dhansel/PaperTapeReader/schematics/mainboard-pcb.pdf

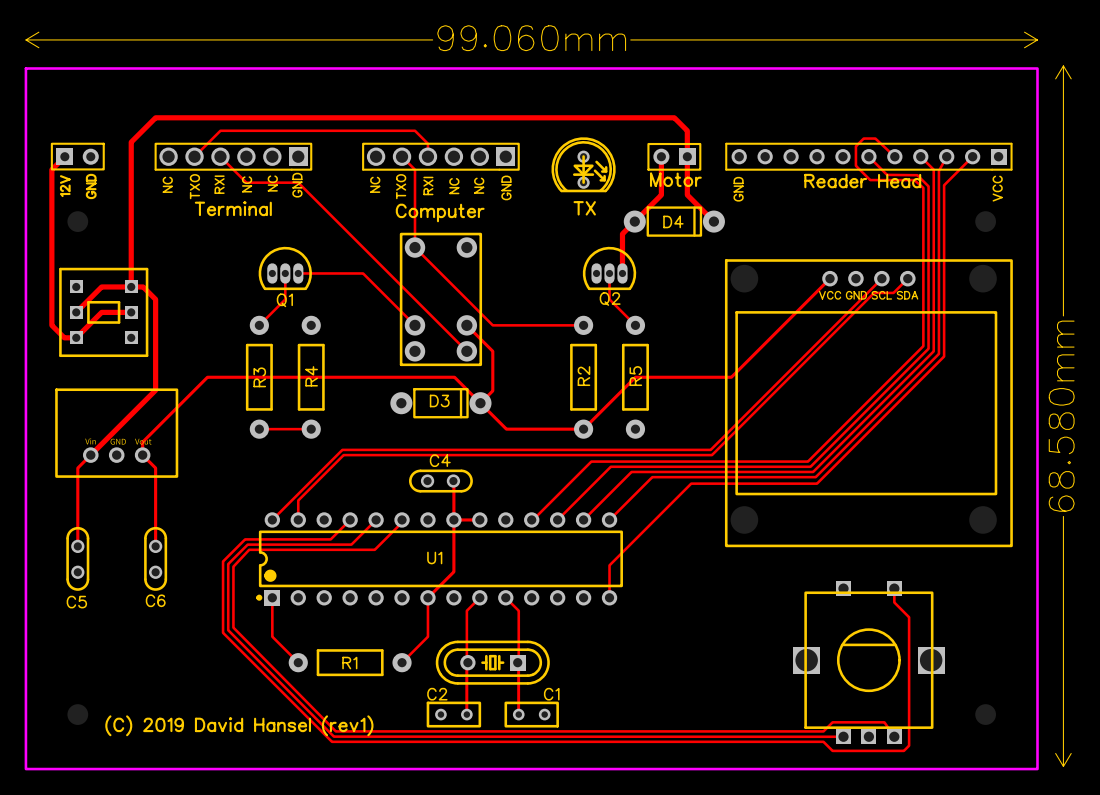
[picture p13: page 1]
