dhansel/PaperTapeReader/schematics/mainboard-schematic.pdf

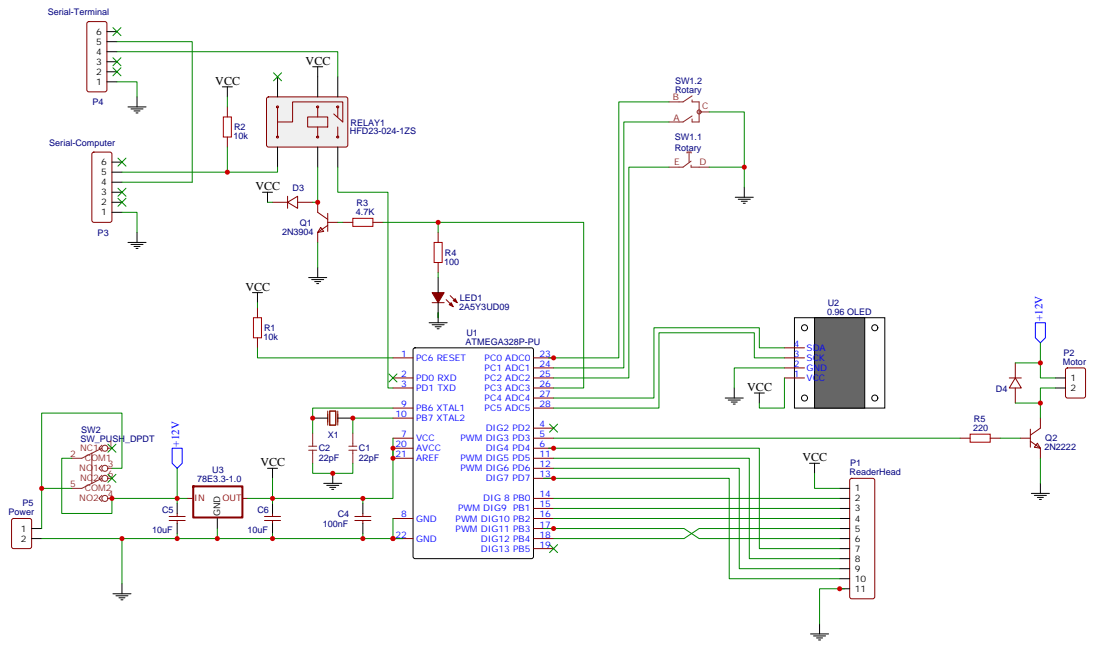
[picture p14: page 1]
