dhansel/PaperTapeReader/schematics/readerhead-emitter-pcb.pdf

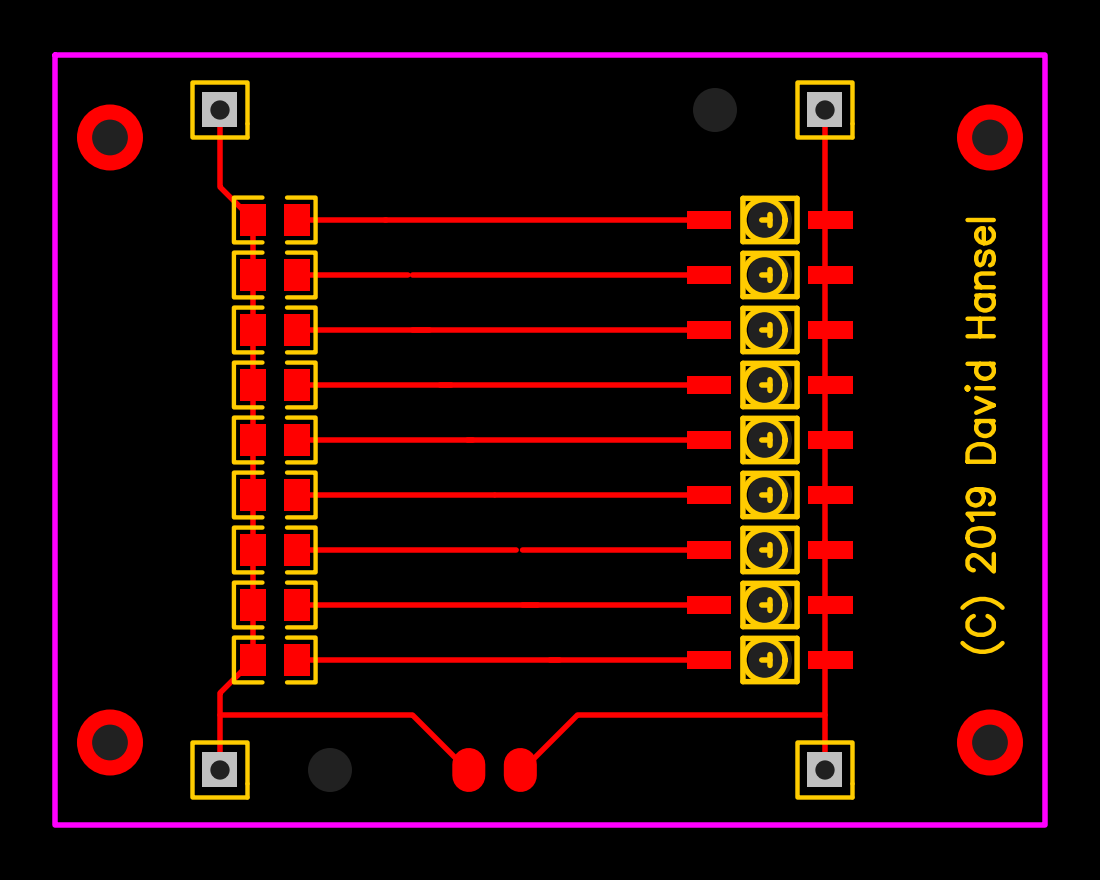
[picture p15: page 1]
