dhansel/PaperTapeReader/schematics/readerhead-sensor-pcb.pdf

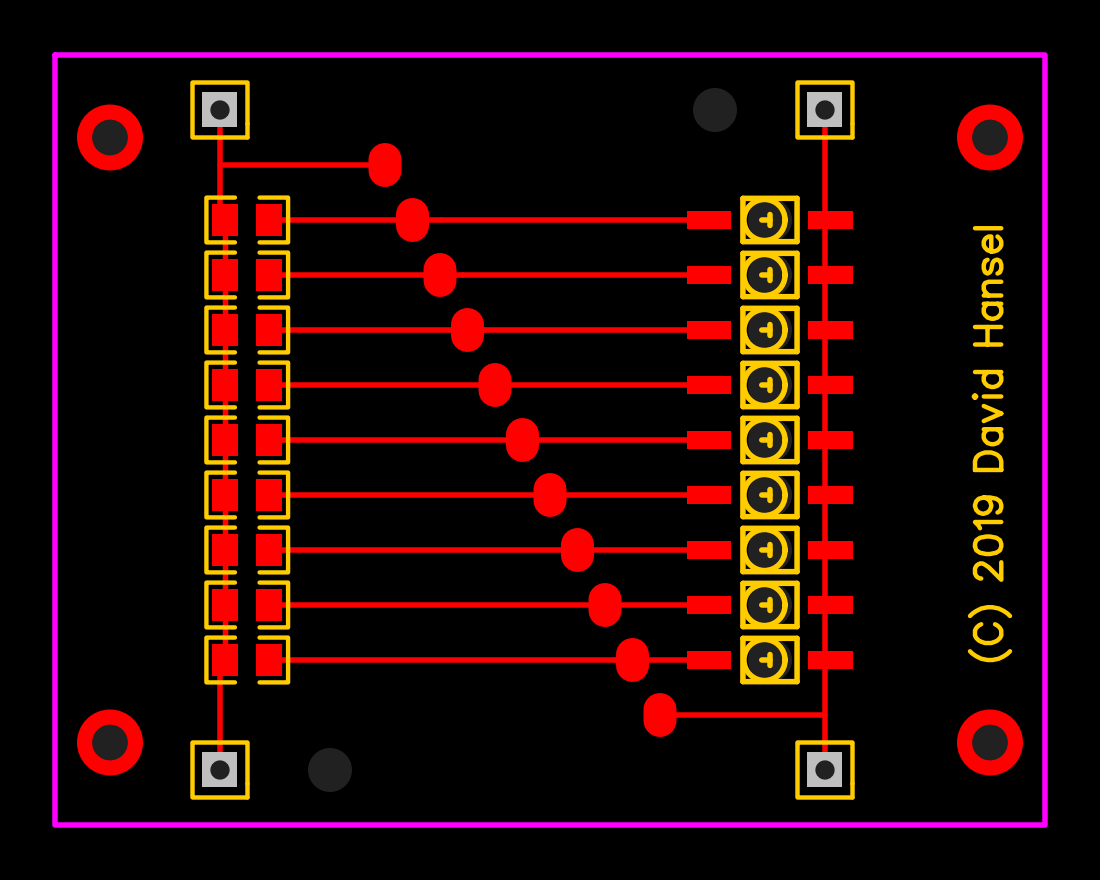
[picture p16: page 1]
