dhansel/PaperTapeReader/(list of files, drawings)

Other design files:
schematics/mainboard-easyeda-pcb.json
schematics/mainboard-easyeda-schematic.json
schematics/readerhead-emitter-easyeda-pcb.json
schematics/readerhead-sensor-easyeda-pcb.json
