dhansel/PaperTapeReader/firmware/PaperTapeReader/basic.h

const byte basic[] PROGMEM = {
  0xae, // leader
  0xc9, 0x7a, 0x47, 0x80, 0x57, 0x01, 0xdb, 0x0f, 0xa0, 0xc2, 0x01, 0xe6, 0x00, 0xdb, 0xc9, 0x67,
  0x0f, 0xa0, 0xcd, 0x6f, 0x0f, 0xa0, 0xcd, 0x0f, 0x8e, 0xc3, 0x13, 0xd3, 0x11, 0xd3, 0x01, 0xd3,
  0x4f, 0x3e, 0x01, 0x4d, 0x3e, 0x01, 0x43, 0x3e, 0x0f, 0x47, 0xca, 0xb9, 0x0f, 0xa0, 0xcd, 0x48,
  0x0f, 0x61, 0xc2, 0x0d, 0x23, 0x0f, 0x89, 0xc2, 0xbe, 0x77, 0xe1, 0x0f, 0x8c, 0xd2, 0x19, 0xff,
  0x4e, 0x11, 0x0f, 0x73, 0xd2, 0x19, 0xf1, 0x00, 0x11, 0xe5, 0x0f, 0xa0, 0xcd, 0x0f, 0x97, 0xcd,
  0x00, 0x06, 0x4f, 0x0f, 0xa0, 0xcd, 0xe9, 0x0f, 0x97, 0xcd, 0x0f, 0x47, 0xc2, 0x78, 0xfe, 0x0f,
  0x58, 0xca, 0x3c, 0xfe, 0x0f, 0xa0, 0xcd, 0x0f, 0xa8, 0x32, 0x3c, 0x0f, 0xa1, 0x32, 0x0f, 0xa3,
  0x22, 0x78, 0x12, 0xd3, 0x04, 0x3e, 0x13, 0xd3, 0x2f, 0x12, 0xd3, 0xaf, 0x40, 0x2e, 0x0f, 0x3c,
  0xc3, 0xc2, 0x01, 0x21, 0x06, 0x06, 0xda, 0x00, 0x06, 0x0f, 0x3c, 0xda, 0x2d, 0x17, 0x0f, 0x30,
  0xda, 0x17, 0x10, 0x06, 0x0f, 0x3c, 0xda, 0x02, 0x2e, 0x17, 0x0f, 0x3c, 0xda, 0x20, 0x2e, 0x17,
  0x0f, 0x28, 0xda, 0x17, 0x00, 0x06, 0xca, 0x26, 0xff, 0xdb, 0x0f, 0xb2, 0x31, 0xf3, 0x00, 0x00,
  0x3c, 0xff, 0xff, 0x00, 0xc7, 0x4f, 0xc4, 0x46, 0xc3, 0x4f, 0xd6, 0x4f, 0xcd, 0x55, 0xd3, 0x42,
  0xd3, 0x44, 0xc4, 0x2f, 0xb0, 0x49, 0xc4, 0x2c, 0x00, 0x00, 0x00, 0x00, 0x00, 0x00, 0x00, 0x00,
  0x00, 0x00, 0x00, 0x00, 0x00, 0x00, 0x00, 0x00, 0x00, 0x00, 0x00, 0x00, 0x00, 0x00, 0x00, 0x00,
  0x00, 0x00, 0x00, 0x00, 0x00, 0x00, 0x00, 0x00, 0x00, 0x00, 0x00, 0x00, 0x00, 0x00, 0x00, 0x00,
  0x00, 0x00, 0x00, 0x00, 0x00, 0x00, 0x00, 0x00, 0x00, 0x00, 0x00, 0x00, 0x00, 0x00, 0x00, 0x00,
  0x00, 0x00, 0x00, 0x00, 0x00, 0x00, 0x00, 0x00, 0x00, 0x00, 0x00, 0x00, 0x00, 0x00, 0x00, 0x00,
  0x00, 0x00, 0x00, 0x00, 0x00, 0x00, 0x00, 0x00, 0x1a, 0x0f, 0x00, 0x00, 0x00, 0x00, 0x00, 0x00,
  0x00, 0x00, 0x00, 0x00, 0x00, 0x00, 0x00, 0x00, 0x00, 0x00, 0x00, 0x00, 0x00, 0x00, 0x00, 0x00,
  0x00, 0x00, 0x00, 0x00, 0x00, 0x00, 0x20, 0x45, 0x52, 0x52, 0x4f, 0xd2, 0x00, 0x20, 0x49, 0x4e,
  0xa0, 0x00, 0x0d, 0x4f, 0xcb, 0x0d, 0x00, 0x21, 0x04, 0x00, 0x39, 0x7e, 0x23, 0xfe, 0x81, 0xc0,
  0xf7, 0xe3, 0xe7, 0x01, 0x0d, 0x00, 0xe1, 0xc8, 0x09, 0xc3, 0x96, 0x01, 0xcd, 0xc3, 0x01, 0xc5,
  0xe3, 0xc1, 0xe7, 0x7e, 0x02, 0xc8, 0x0b, 0x2b, 0xc3, 0xad, 0x01, 0xe5, 0x2a, 0x6b, 0x01, 0x06,
  0x00, 0x09, 0x09, 0xcd, 0xc3, 0x01, 0xe1, 0xc9, 0xd5, 0xeb, 0x21, 0xde, 0xff, 0x39, 0xe7, 0xeb,
  0xd1, 0xd0, 0x1e, 0x0c, 0x01, 0x1e, 0x02, 0x01, 0x1e, 0x14, 0xcd, 0xb5, 0x02, 0xcd, 0x8a, 0x05,
  0x21, 0xfa, 0x00, 0x57, 0x3e, 0x3f, 0xdf, 0x19, 0x7e, 0xdf, 0xd7, 0xdf, 0x21, 0x81, 0x01, 0xcd,
  0xa3, 0x05, 0x2a, 0x61, 0x01, 0x7c, 0xa5, 0x3c, 0xc4, 0x2f, 0x0b, 0x01, 0xc0, 0xc1, 0x21, 0x8d,
  0x01, 0xcd, 0x21, 0xf5, 0x3c, 0xff, 0xfe, 0x01, 0x0d, 0x21, 0xff, 0xff, 0x22, 0x61, 0x01, 0xcd,
  0x3c, 0x03, 0xd7, 0x3c, 0x3d, 0xca, 0xff, 0x01, 0xf5, 0xcd, 0x9d, 0x04, 0xd5, 0xcd, 0xcc, 0x02,
  0x47, 0xd1, 0xf1, 0xd2, 0x3e, 0x04, 0xd5, 0xc5, 0xd7, 0xb7, 0xf5, 0xcd, 0x7d, 0x02, 0xc5, 0xd2,
  0x39, 0x02, 0xeb, 0x2a, 0x67, 0x01, 0x1a, 0x02, 0x03, 0x13, 0xe7, 0xc2, 0x2c, 0x02, 0x60, 0x69,
  0x22, 0x67, 0x01, 0xd1, 0xf1, 0xca, 0x60, 0x02, 0x2a, 0x67, 0x01, 0xe3, 0xc1, 0x09, 0xe5, 0xcd,
  0xa7, 0x01, 0xe1, 0x22, 0x67, 0x01, 0xeb, 0x74, 0x23, 0x23, 0xd1, 0x73, 0x23, 0x72, 0x23, 0x11,
  0x13, 0x01, 0x1a, 0x77, 0x23, 0x13, 0xb7, 0xc2, 0x58, 0x02, 0xcd, 0xa2, 0x02, 0x23, 0xeb, 0x62,
  0x6b, 0x7e, 0x23, 0xb6, 0xca, 0xff, 0x01, 0x23, 0x23, 0x23, 0xaf, 0xbe, 0x23, 0xc2, 0x71, 0x02,
  0xeb, 0x73, 0x23, 0x72, 0xc3, 0x65, 0x02, 0x2a, 0x65, 0x01, 0x44, 0x4d, 0x7e, 0x23, 0xb6, 0x2b,
  0xc8, 0xc5, 0xf7, 0xf7, 0xe1, 0xe7, 0xe1, 0xc1, 0x3f, 0xc8, 0x3f, 0xd0, 0xc3, 0x80, 0x02, 0xc0,
  0x2a, 0x65, 0x01, 0xaf, 0x77, 0x23, 0x77, 0x23, 0x22, 0x67, 0x01, 0xc0, 0x2a, 0x65, 0x01, 0x2b,
  0x22, 0x5d, 0x01, 0xcd, 0x69, 0x04, 0x2a, 0x67, 0x01, 0x22, 0x69, 0x01, 0x22, 0x6b, 0x01, 0xc1,
  0x2a, 0x63, 0x01, 0xf9, 0xaf, 0x6f, 0xe5, 0xc5, 0x2a, 0x5d, 0x01, 0xc9, 0x3e, 0x3f, 0xdf, 0x3e,
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
