dhansel/PaperTapeReader/firmware/PaperTapeReader/lunar.h

const byte lunar[] PROGMEM = { 
   0x00, // leader
   0x31, 0x30, 0x30, 0x20, 0x52, 0x45, 0x4d, 0x2d, 0x2d, 0x2d, 0x2d, 0x2d, 0x2d, 0x2d, 0x2d, 0x2d,
   0x2d, 0x2d, 0x2d, 0x2d, 0x2d, 0x2d, 0x2d, 0x2d, 0x2d, 0x2d, 0x2d, 0x2d, 0x2d, 0x2d, 0x2d, 0x2d,
   0x2d, 0x2d, 0x2d, 0x2d, 0x2d, 0x2d, 0x2d, 0x2d, 0x2d, 0x2d, 0x2d, 0x2d, 0x2d, 0x2d, 0x2d, 0x2d,
   0x2d, 0x2d, 0x2d, 0x2d, 0x2d, 0x2d, 0x2d, 0x2d, 0x2d, 0x2d, 0x2d, 0x0d, 0x0a, 0x31, 0x30, 0x31,
   0x20, 0x52, 0x45, 0x4d, 0x20, 0x20, 0x20, 0x20, 0x20, 0x20, 0x20, 0x4c, 0x20, 0x20, 0x41, 0x20,
   0x20, 0x4e, 0x20, 0x20, 0x44, 0x20, 0x20, 0x45, 0x20, 0x20, 0x52, 0x0d, 0x0a, 0x31, 0x30, 0x32,
   0x20, 0x52, 0x45, 0x4d, 0x2d, 0x2d, 0x2d, 0x2d, 0x2d, 0x2d, 0x2d, 0x2d, 0x2d, 0x2d, 0x2d, 0x2d,
   0x2d, 0x2d, 0x2d, 0x2d, 0x2d, 0x2d, 0x2d, 0x2d, 0x2d, 0x2d, 0x2d, 0x2d, 0x2d, 0x2d, 0x2d, 0x2d,
   0x2d, 0x2d, 0x2d, 0x2d, 0x2d, 0x2d, 0x2d, 0x2d, 0x2d, 0x2d, 0x2d, 0x2d, 0x2d, 0x2d, 0x2d, 0x2d,
   0x2d, 0x2d, 0x2d, 0x2d, 0x2d, 0x2d, 0x2d, 0x2d, 0x0d, 0x0a, 0x31, 0x30, 0x33, 0x20, 0x52, 0x45,
   0x4d, 0x20, 0x20, 0x20, 0x20, 0x20, 0x20, 0x20, 0x20, 0x4a, 0x55, 0x4e, 0x45, 0x20, 0x31, 0x36,
   0x2c, 0x20, 0x31, 0x39, 0x37, 0x37, 0x0d, 0x0a, 0x31, 0x30, 0x34, 0x20, 0x52, 0x45, 0x4d, 0x20,
   0x54, 0x48, 0x49, 0x53, 0x20, 0x56, 0x45, 0x52, 0x53, 0x49, 0x4f, 0x4e, 0x20, 0x4f, 0x46, 0x20,
   0x4c, 0x55, 0x4e, 0x41, 0x52, 0x20, 0x4c, 0x41, 0x4e, 0x44, 0x45, 0x52, 0x20, 0x49, 0x53, 0x20,
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
   0x54, 0x41, 0x4b, 0x45, 0x4e, 0x22, 0x0d, 0x0a, 0x31, 0x30, 0x37, 0x37, 0x20, 0x50, 0x52, 0x49,
   0x4e, 0x54, 0x22, 0x4f, 0x56, 0x45, 0x52, 0x20, 0x4d, 0x41, 0x4e, 0x55, 0x41, 0x4c, 0x20, 0x43,
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
