dhansel/PaperTapeReader/firmware/PaperTapeReader/tictactoe.h

const byte tictac[] PROGMEM = { 
  0x00, // leader
  0x31, 0x20, 0x44, 0x41, 0x54, 0x41, 0x20, 0x32, 0x2c, 0x33, 0x2c, 0x34, 0x2c, 0x39, 0x2c, 0x31,
  0x2c, 0x35, 0x2c, 0x38, 0x2c, 0x37, 0x2c, 0x36, 0x20, 0x0d, 0x0a, 0x32, 0x20, 0x44, 0x41, 0x54,
  0x41, 0x20, 0x32, 0x2c, 0x33, 0x2c, 0x34, 0x2c, 0x39, 0x2c, 0x31, 0x2c, 0x35, 0x2c, 0x38, 0x2c,
  0x37, 0x2c, 0x36, 0x2c, 0x32, 0x2c, 0x39, 0x2c, 0x38, 0x2c, 0x33, 0x2c, 0x31, 0x2c, 0x37, 0x20,
  0x0d, 0x0a, 0x33, 0x20, 0x44, 0x41, 0x54, 0x41, 0x20, 0x34, 0x2c, 0x35, 0x2c, 0x36, 0x2c, 0x32,
  0x2c, 0x31, 0x2c, 0x36, 0x2c, 0x34, 0x2c, 0x31, 0x2c, 0x38, 0x20, 0x0d, 0x0a, 0x34, 0x20, 0x44,
  0x41, 0x54, 0x41, 0x20, 0x30, 0x2c, 0x31, 0x2c, 0x2d, 0x31, 0x2c, 0x31, 0x2c, 0x2d, 0x31, 0x2c,
  0x31, 0x2c, 0x2d, 0x31, 0x2c, 0x31, 0x2c, 0x2d, 0x31, 0x20, 0x0d, 0x0a, 0x35, 0x20, 0x44, 0x49,
  0x4d, 0x20, 0x41, 0x28, 0x39, 0x29, 0x20, 0x0d, 0x0a, 0x36, 0x20, 0x44, 0x49, 0x4d, 0x20, 0x42,
  0x28, 0x39, 0x29, 0x20, 0x0d, 0x0a, 0x37, 0x20, 0x44, 0x49, 0x4d, 0x20, 0x43, 0x28, 0x32, 0x34,
  0x29, 0x0d, 0x0a, 0x38, 0x20, 0x44, 0x49, 0x4d, 0x20, 0x44, 0x28, 0x32, 0x34, 0x29, 0x0d, 0x0a,
  0x39, 0x20, 0x44, 0x49, 0x4d, 0x20, 0x46, 0x28, 0x39, 0x29, 0x20, 0x0d, 0x0a, 0x31, 0x30, 0x20,
  0x46, 0x4f, 0x52, 0x20, 0x49, 0x3d, 0x31, 0x20, 0x54, 0x4f, 0x20, 0x39, 0x20, 0x0d, 0x0a, 0x31,
  0x31, 0x20, 0x52, 0x45, 0x41, 0x44, 0x20, 0x41, 0x28, 0x49, 0x29, 0x0d, 0x0a, 0x31, 0x32, 0x20,
  0x4e, 0x45, 0x58, 0x54, 0x20, 0x49, 0x20, 0x0d, 0x0a, 0x31, 0x33, 0x20, 0x46, 0x4f, 0x52, 0x20,
  0x49, 0x3d, 0x31, 0x20, 0x54, 0x4f, 0x20, 0x32, 0x34, 0x0d, 0x0a, 0x31, 0x34, 0x20, 0x52, 0x45,
  0x41, 0x44, 0x20, 0x43, 0x28, 0x49, 0x29, 0x0d, 0x0a, 0x31, 0x35, 0x20, 0x4e, 0x45, 0x58, 0x54,
  0x20, 0x49, 0x20, 0x0d, 0x0a, 0x31, 0x36, 0x20, 0x46, 0x4f, 0x52, 0x20, 0x49, 0x3d, 0x31, 0x20,
  0x54, 0x4f, 0x20, 0x39, 0x20, 0x0d, 0x0a, 0x31, 0x37, 0x20, 0x52, 0x45, 0x41, 0x44, 0x20, 0x46,
  0x28, 0x49, 0x29, 0x0d, 0x0a, 0x31, 0x38, 0x20, 0x4e, 0x45, 0x58, 0x54, 0x20, 0x49, 0x20, 0x0d,
  0x0a, 0x31, 0x39, 0x20, 0x50, 0x52, 0x49, 0x4e, 0x54, 0x20, 0x22, 0x54, 0x49, 0x43, 0x2d, 0x54,
  0x41, 0x43, 0x2d, 0x54, 0x4f, 0x45, 0x22, 0x0d, 0x0a, 0x32, 0x30, 0x20, 0x50, 0x52, 0x49, 0x4e,
  0x54, 0x0d, 0x0a, 0x32, 0x31, 0x20, 0x50, 0x52, 0x49, 0x4e, 0x54, 0x20, 0x22, 0x54, 0x48, 0x45,
  0x20, 0x4d, 0x4f, 0x56, 0x45, 0x20, 0x50, 0x4f, 0x53, 0x49, 0x54, 0x49, 0x4f, 0x4e, 0x53, 0x20,
  0x41, 0x52, 0x45, 0x3a, 0x22, 0x0d, 0x0a, 0x32, 0x32, 0x20, 0x50, 0x52, 0x49, 0x4e, 0x54, 0x0d,
  0x0a, 0x32, 0x33, 0x20, 0x50, 0x52, 0x49, 0x4e, 0x54, 0x20, 0x22, 0x31, 0x20, 0x32, 0x20, 0x33,
  0x22, 0x0d, 0x0a, 0x32, 0x34, 0x20, 0x50, 0x52, 0x49, 0x4e, 0x54, 0x20, 0x22, 0x34, 0x20, 0x35,
  0x20, 0x36, 0x22, 0x0d, 0x0a, 0x32, 0x35, 0x20, 0x50, 0x52, 0x49, 0x4e, 0x54, 0x20, 0x22, 0x37,
  0x20, 0x38, 0x20, 0x39, 0x22, 0x0d, 0x0a, 0x32, 0x36, 0x20, 0x47, 0x4f, 0x53, 0x55, 0x42, 0x20,
  0x31, 0x33, 0x33, 0x0d, 0x0a, 0x32, 0x37, 0x20, 0x47, 0x4f, 0x53, 0x55, 0x42, 0x20, 0x31, 0x33,
  0x33, 0x0d, 0x0a, 0x33, 0x32, 0x20, 0x4c, 0x45, 0x54, 0x20, 0x45, 0x3d, 0x30, 0x0d, 0x0a, 0x33,
  0x33, 0x20, 0x4c, 0x45, 0x54, 0x20, 0x47, 0x3d, 0x32, 0x0d, 0x0a, 0x33, 0x34, 0x20, 0x4c, 0x45,
  0x54, 0x20, 0x4b, 0x3d, 0x30, 0x0d, 0x0a, 0x33, 0x35, 0x20, 0x46, 0x4f, 0x52, 0x20, 0x49, 0x3d,
  0x31, 0x20, 0x54, 0x4f, 0x20, 0x39, 0x20, 0x0d, 0x0a, 0x33, 0x36, 0x20, 0x4c, 0x45, 0x54, 0x20,
  0x42, 0x28, 0x49, 0x29, 0x3d, 0x30, 0x20, 0x0d, 0x0a, 0x33, 0x37, 0x20, 0x4e, 0x45, 0x58, 0x54,
  0x20, 0x49, 0x20, 0x0d, 0x0a, 0x33, 0x38, 0x20, 0x46, 0x4f, 0x52, 0x20, 0x49, 0x3d, 0x31, 0x20,
  0x54, 0x4f, 0x20, 0x32, 0x34, 0x0d, 0x0a, 0x33, 0x39, 0x20, 0x4c, 0x45, 0x54, 0x20, 0x44, 0x28,
  0x49, 0x29, 0x3d, 0x30, 0x20, 0x0d, 0x0a, 0x34, 0x30, 0x20, 0x4e, 0x45, 0x58, 0x54, 0x20, 0x49,
  0x20, 0x0d, 0x0a, 0x34, 0x31, 0x20, 0x50, 0x52, 0x49, 0x4e, 0x54, 0x0d, 0x0a, 0x34, 0x32, 0x20,
  0x50, 0x52, 0x49, 0x4e, 0x54, 0x0d, 0x0a, 0x34, 0x33, 0x20, 0x50, 0x52, 0x49, 0x4e, 0x54, 0x20,
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
