dhansel/PaperTapeReader/firmware/PaperTapeReader/wumpus.h

const byte wumpus[] PROGMEM = { 
   0x00, // leader
   0x0d, 0x0a, 0x31, 0x20, 0x52, 0x45, 0x4d, 0x20, 0x57, 0x55, 0x4d, 0x50, 0x55, 0x53, 0x20, 0x31,
   0x2f, 0x32, 0x38, 0x2f, 0x37, 0x37, 0x0d, 0x0a, 0x32, 0x20, 0x52, 0x45, 0x4d, 0x20, 0x4d, 0x4f,
   0x44, 0x49, 0x46, 0x49, 0x45, 0x44, 0x20, 0x46, 0x4f, 0x52, 0x20, 0x41, 0x4c, 0x54, 0x41, 0x49,
   0x52, 0x20, 0x34, 0x4b, 0x20, 0x42, 0x41, 0x53, 0x49, 0x43, 0x20, 0x31, 0x30, 0x2f, 0x30, 0x31,
   0x0d, 0x0a, 0x33, 0x20, 0x52, 0x45, 0x4d, 0x20, 0x52, 0x45, 0x43, 0x4f, 0x44, 0x45, 0x44, 0x20,
   0x2d, 0x3e, 0x20, 0x43, 0x48, 0x41, 0x52, 0x41, 0x43, 0x54, 0x45, 0x52, 0x53, 0x2c, 0x20, 0x43,
   0x4f, 0x4d, 0x50, 0x55, 0x54, 0x45, 0x44, 0x20, 0x47, 0x4f, 0x54, 0x4f, 0x53, 0x2c, 0x20, 0x22,
   0x4f, 0x52, 0x22, 0x20, 0x53, 0x54, 0x41, 0x54, 0x45, 0x4d, 0x45, 0x4e, 0x54, 0x53, 0x2c, 0x20,
   0x32, 0x2d, 0x44, 0x20, 0x41, 0x52, 0x52, 0x41, 0x59, 0x0d, 0x0a, 0x34, 0x20, 0x52, 0x45, 0x4d,
   0x20, 0x20, 0x20, 0x20, 0x20, 0x20, 0x20, 0x20, 0x20, 0x20, 0x20, 0x20, 0x43, 0x4f, 0x4d, 0x50,
   0x55, 0x54, 0x45, 0x44, 0x20, 0x4c, 0x4f, 0x47, 0x49, 0x43, 0x41, 0x4c, 0x20, 0x53, 0x54, 0x41,
   0x54, 0x45, 0x4d, 0x45, 0x4e, 0x54, 0x53, 0x0d, 0x0a, 0x31, 0x30, 0x20, 0x50, 0x52, 0x49, 0x4e,
   0x54, 0x22, 0x57, 0x4d, 0x50, 0x32, 0x33, 0x2d, 0x48, 0x55, 0x4e, 0x54, 0x20, 0x54, 0x48, 0x45,
   0x20, 0x57, 0x55, 0x4d, 0x50, 0x55, 0x53, 0x22, 0x0d, 0x0a, 0x31, 0x35, 0x20, 0x50, 0x52, 0x49,
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
   0x34, 0x2c, 0x32, 0x30, 0x2c, 0x34, 0x2c, 0x31, 0x33, 0x2c, 0x31, 0x35, 0x2c, 0x36, 0x2c, 0x31,
   0x34, 0x2c, 0x31, 0x36, 0x0d, 0x0a, 0x31, 0x36, 0x30, 0x20, 0x44, 0x41, 0x54, 0x41, 0x20, 0x31,
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
