dhansel/PaperTapeReader/(commit log)

2020-02-16 added schematics for main board and reader head
2020-02-16 added EasyEDA files
    [mainboard-easyeda-pcb.json, mainboard-easyeda-schematic.json]
2020-02-16 Moved Arduino sketch into subdirectory
2021-09-06 Fixed issues and Improved support for baud rates <= 300 baud (now properly supporting 55, 75, 110, 150, 300 baud)
    [PaperTapeReader.ino]
